tuguldur0/haven-badge/parts/boost/claude_kox4i6dn2g.png

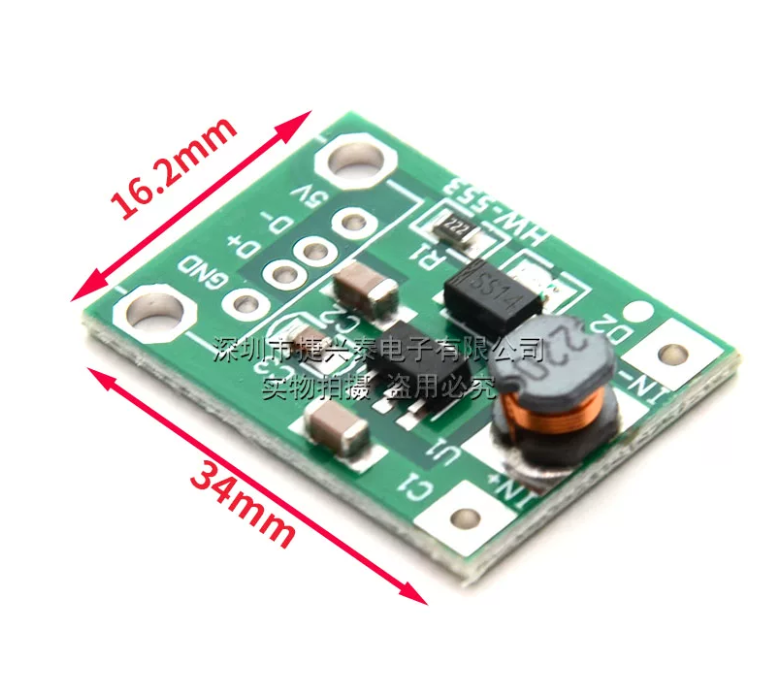
parts/boost/claude_kox4i6dn2g.png
