tuguldur0/haven-badge/parts/boost/claude_8iC5iIxjjv.png

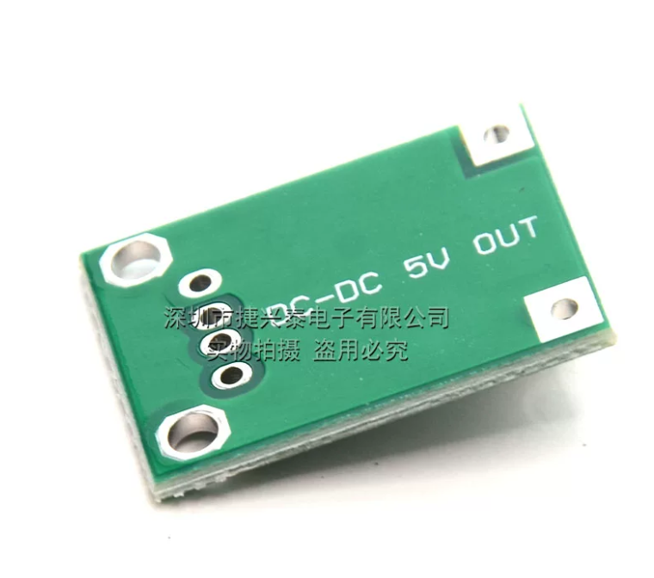
parts/boost/claude_8iC5iIxjjv.png
