tuguldur0/haven-badge/parts/boost/claude_3SXdJeQExv.png

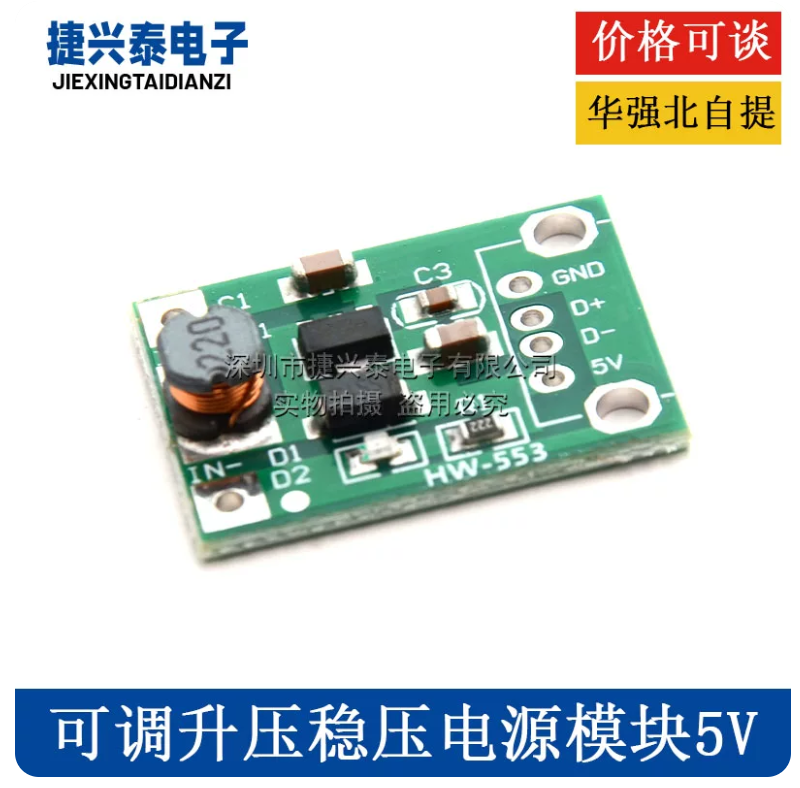
parts/boost/claude_3SXdJeQExv.png
