tuguldur0/haven-badge/parts/display/brave_M3mWcZekrh.png

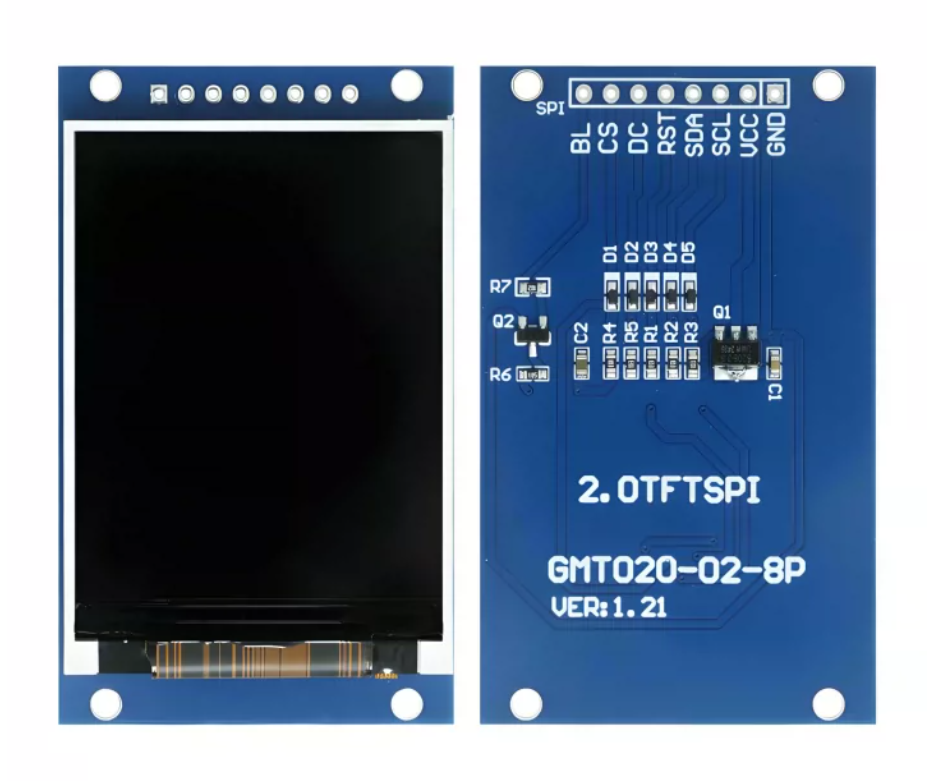
parts/display/brave_M3mWcZekrh.png
