tuguldur0/haven-badge/parts/display/brave_tNfNKGqZeg.png

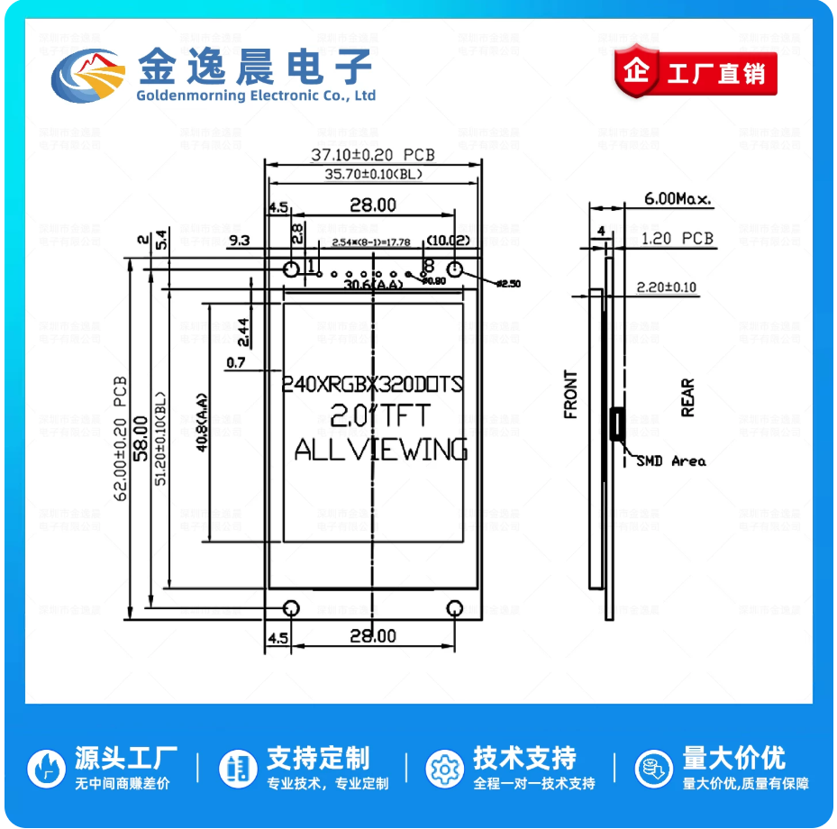
parts/display/brave_tNfNKGqZeg.png
