tuguldur0/haven-badge/parts/display/brave_YLbE1afcdx.png

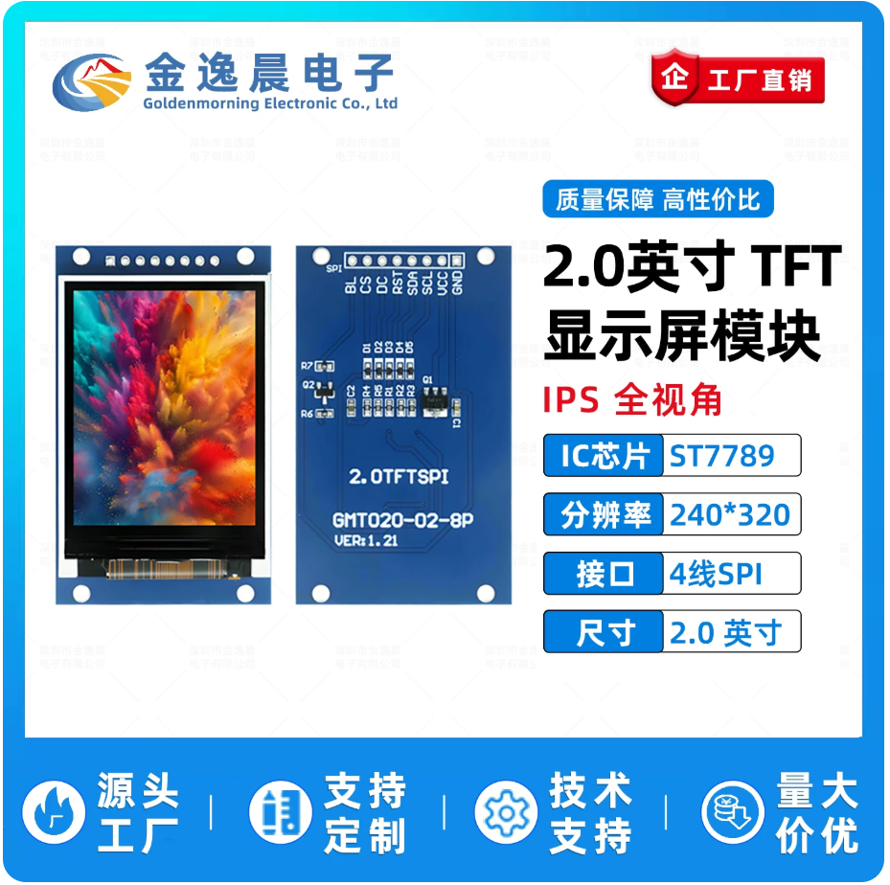
parts/display/brave_YLbE1afcdx.png
