tuguldur0/haven-badge/parts/module/brave_skoJ16uYzu.png

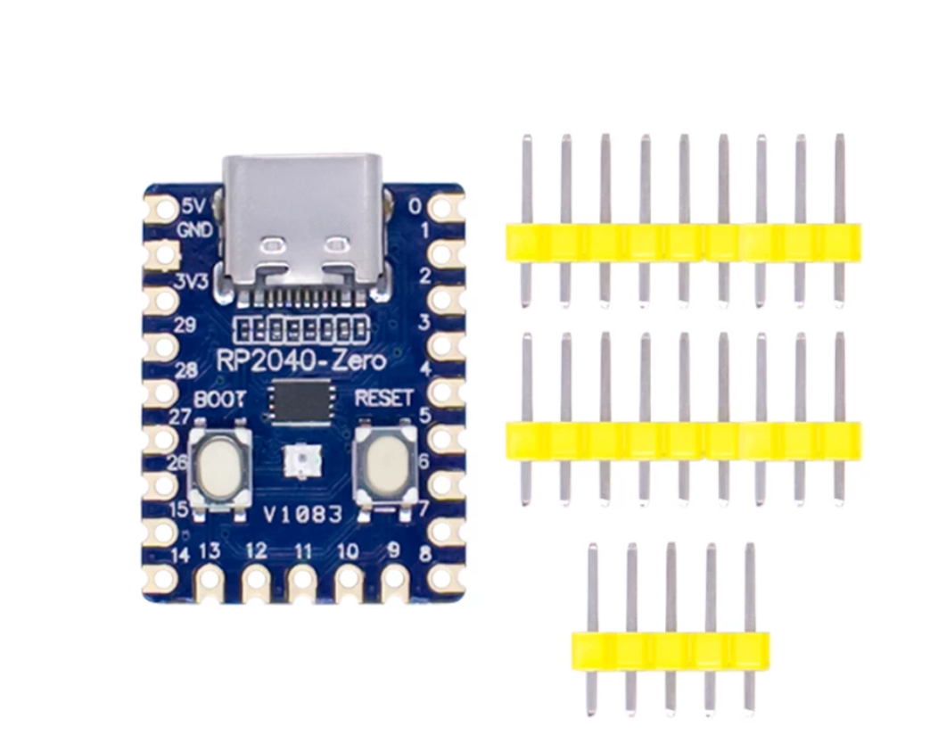
parts/module/brave_skoJ16uYzu.png
