tuguldur0/haven-badge/haven-badge.pdf

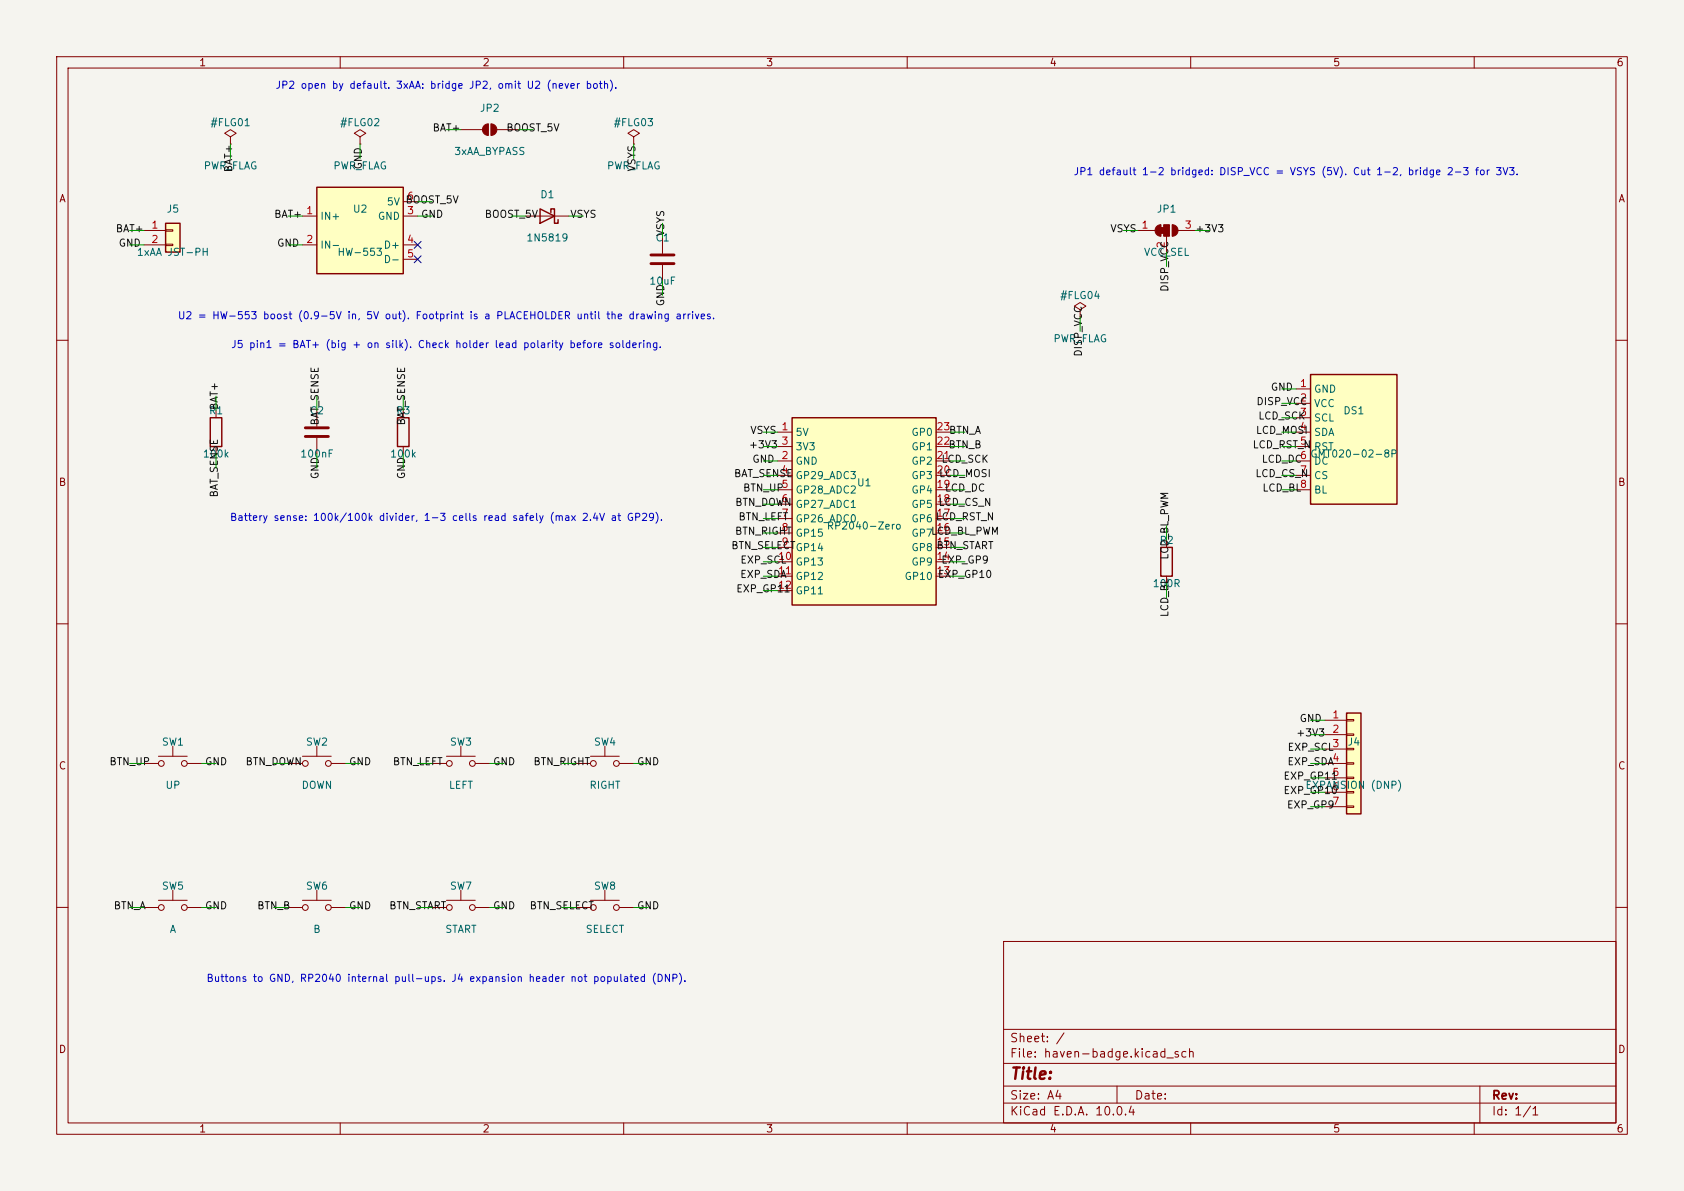
[picture p8: page 1]

Battery sense: 100k/100k divider, 1-3 cells read safely (max 2.4V at GP29). U2 = HW-553 boost (0.9-5V in, 5V out). Footprint is a PLACEHOLDER until the drawing arrives. JP2 open by default. 3xAA: bridge JP2, omit U2 (never both).

Size: A4 | Rev:
KiCad E.D.A. 10.0.4 | Id: 1/1
