tuguldur0/haven-badge/review/back/haven-badge.pdf

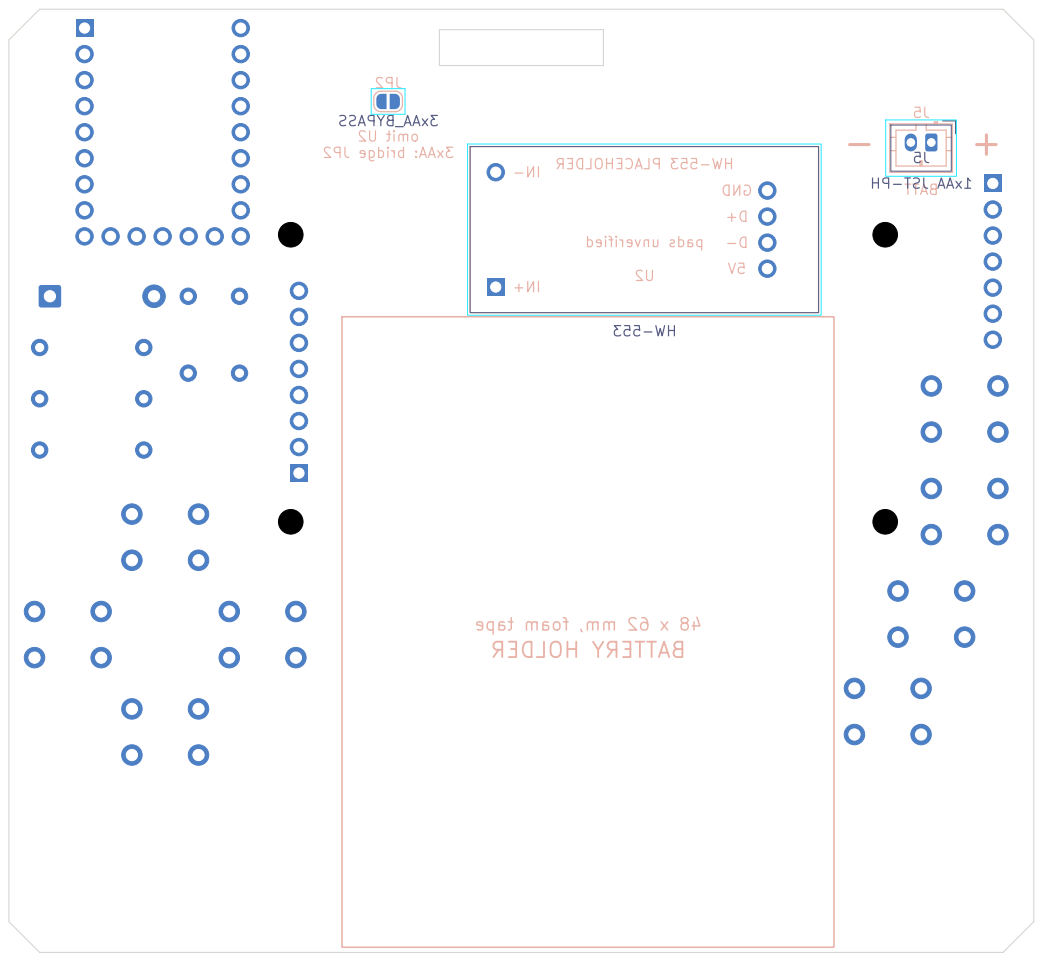
[picture p9: page 1]

JP2 bridge 3xAA: U2 omit HOLDER BATTERY

5V PLACEHOLDER HW-553 unverified pads
