tuguldur0/haven-badge/review/fit-test-1to1/haven-badge.pdf

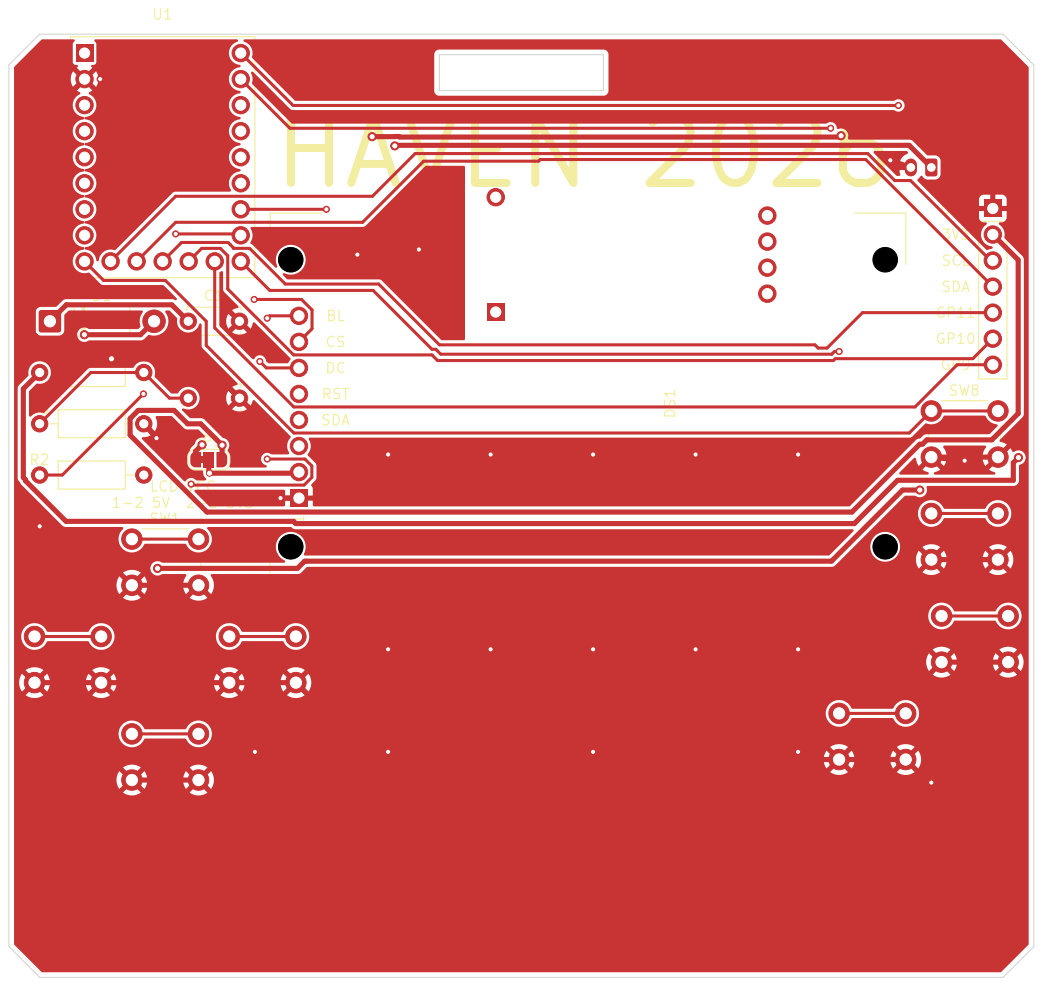
[picture p10: page 1]

CSBL
SCL SDA RST DC
