tuguldur0/haven-badge/review/front/haven-badge.pdf

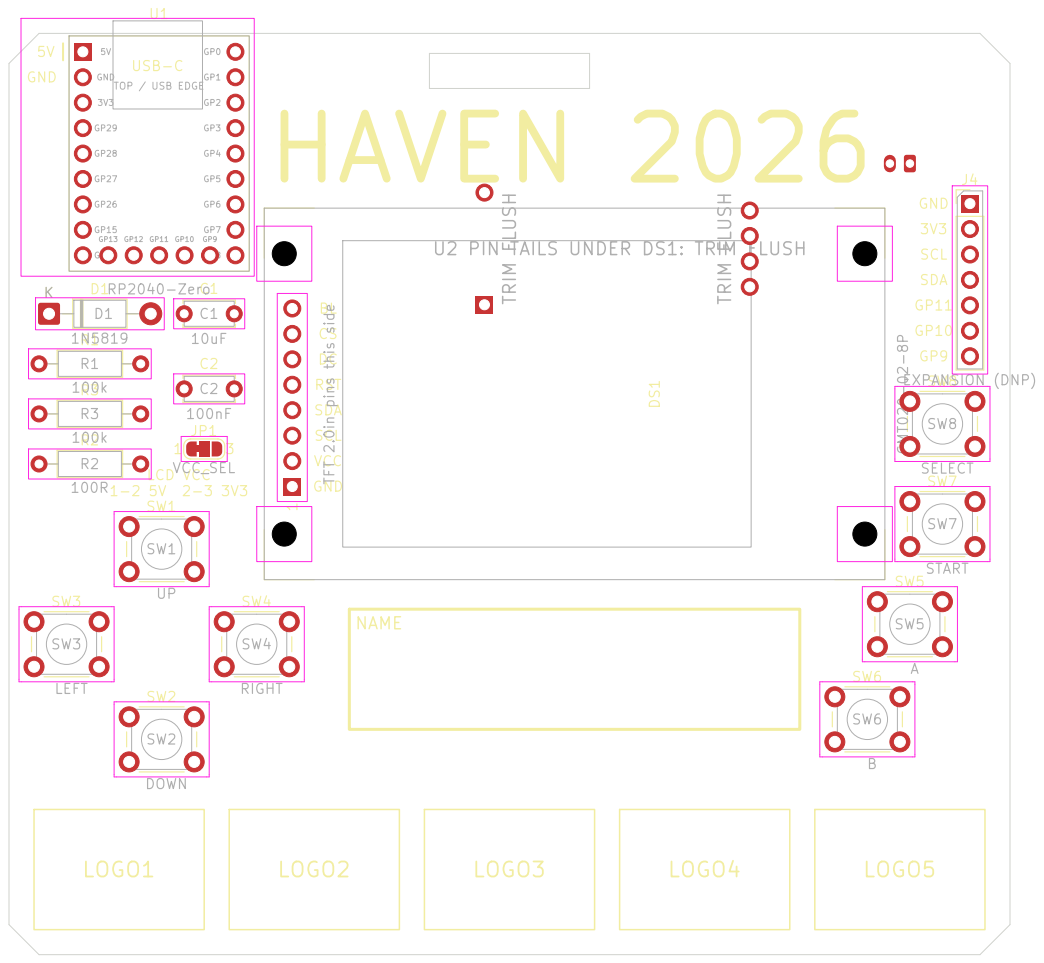
[picture p11: page 1]

SCL SDA RST DC
