tuguldur0/haven-badge/haven-badge.kicad_pcb

## KiCad design haven-badge.kicad_pcb (2026-10-20)

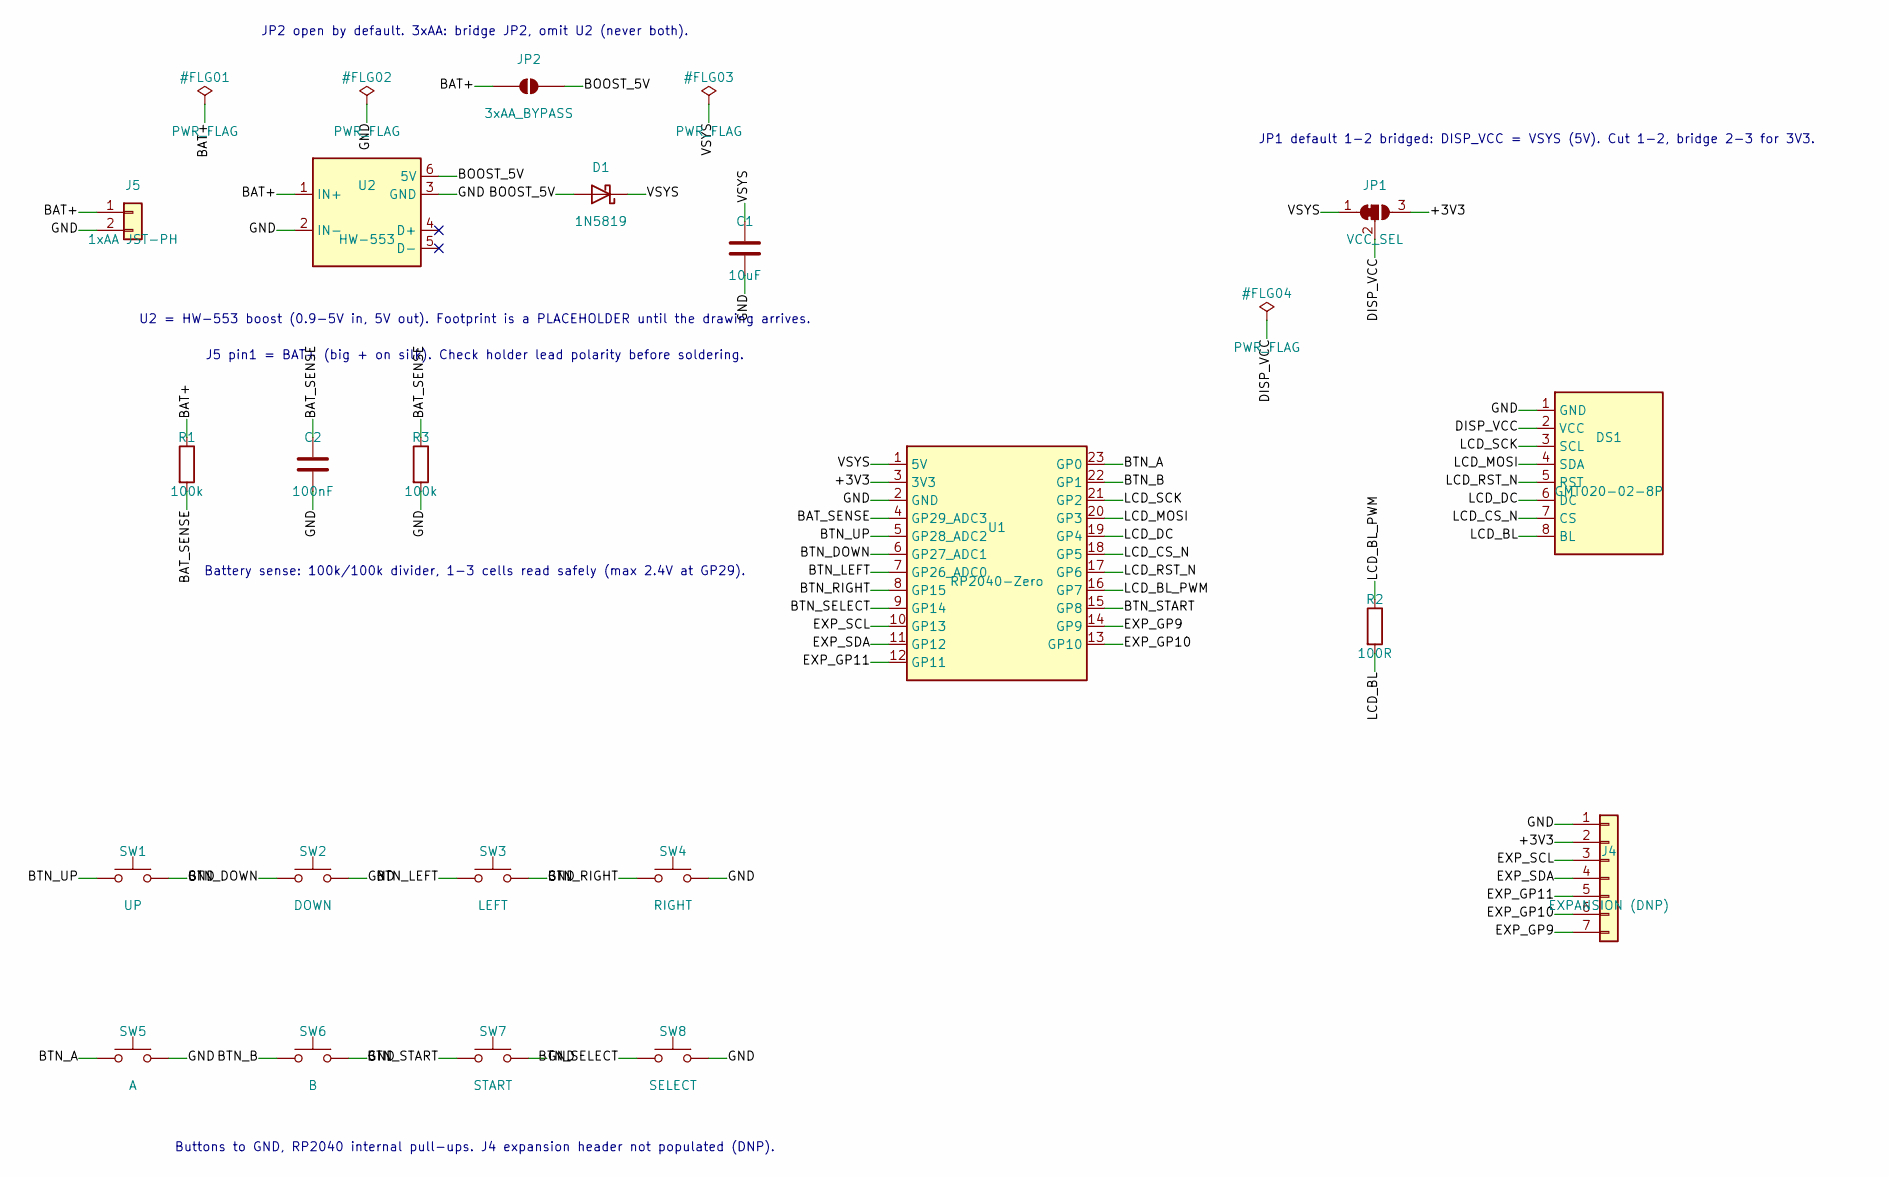
[picture p12: schematic haven-badge.kicad_sch]

Parts:
C1: 10uF; C_Disc_D5.0mm_W2.5mm_P5.00mm
C2: 100nF; C_Disc_D5.0mm_W2.5mm_P5.00mm
D1: 1N5819; D_DO-41_SOD81_P10.16mm_Horizontal
DS1: GMT020-02-8P; GMT020-02-8P_Socketed
J4: EXPANSION (DNP); PinHeader_1x07_P2.54mm_Vertical
J5: 1xAA JST-PH; JST_PH_B2B-PH-K_1x02_P2.00mm_Vertical
JP1: VCC_SEL; SolderJumper-3_P1.3mm_Bridged12_RoundedPad1.0x1.5mm_NumberL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
JP2: 3xAA_BYPASS; SolderJumper-2_P1.3mm_Open_RoundedPad1.0x1.5mm
R1, R3: 100k; R_Axial_DIN0207_L6.3mm_D2.5mm_P10.16mm_Horizontal
R2: 100R; R_Axial_DIN0207_L6.3mm_D2.5mm_P10.16mm_Horizontal
SW1: UP; SW_PUSH_6mm
SW2: DOWN; SW_PUSH_6mm
SW3: LEFT; SW_PUSH_6mm
SW4: RIGHT; SW_PUSH_6mm
SW5: A; SW_PUSH_6mm
SW6: B; SW_PUSH_6mm
SW7: START; SW_PUSH_6mm
SW8: SELECT; SW_PUSH_6mm
U1: RP2040-Zero; RP2040-Zero_Socketed
U2: HW-553; HW-553_Placeholder

Connections:
/+3V3: J4.2, JP1.3 (B), U1.3 (3V3)
/BAT+: J5.1, JP2.1 (A), R1.1, U2.1 (IN+)
/BAT_SENSE: C2.1, R1.2, R3.1, U1.4 (GP29_ADC3)
/BOOST_5V: D1.2 (A), JP2.2 (B), U2.6 (5V)
/BTN_A: SW5.1, U1.23 (GP0)
/BTN_B: SW6.1, U1.22 (GP1)
/BTN_DOWN: SW2.1, U1.6 (GP27_ADC1)
/BTN_LEFT: SW3.1, U1.7 (GP26_ADC0)
/BTN_RIGHT: SW4.1, U1.8 (GP15)
/BTN_SELECT: SW8.1, U1.9 (GP14)
/BTN_START: SW7.1, U1.15 (GP8)
/BTN_UP: SW1.1, U1.5 (GP28_ADC2)
/DISP_VCC: DS1.2 (VCC), JP1.2 (C)
/EXP_GP9: J4.7, U1.14 (GP9)
/EXP_GP10: J4.6, U1.13 (GP10)
/EXP_GP11: J4.5, U1.12 (GP11)
/EXP_SCL: J4.3, U1.10 (GP13)
/EXP_SDA: J4.4, U1.11 (GP12)
/GND: C1.2, C2.2, DS1.1 (GND), J4.1, J5.2, R3.2, SW1.2, SW2.2, SW3.2, SW4.2, SW5.2, SW6.2, SW7.2, SW8.2, U1.2 (GND), U2.2 (IN-), U2.3 (GND)
/LCD_BL: DS1.8 (BL), R2.2
/LCD_BL_PWM: R2.1, U1.16 (GP7)
/LCD_CS_N: DS1.7 (CS), U1.18 (GP5)
/LCD_DC: DS1.6 (DC), U1.19 (GP4)
/LCD_MOSI: DS1.4 (SDA), U1.20 (GP3)
/LCD_RST_N: DS1.5 (RST), U1.17 (GP6)
/LCD_SCK: DS1.3 (SCL), U1.21 (GP2)
/VSYS: C1.1, D1.1 (K), JP1.1 (A), U1.1 (5V)

Notes on the sheet:
U2 = HW-553 boost (0.9-5V in, 5V out). Footprint is a PLACEHOLDER until the drawing arrives.
J5 pin1 = BAT+ (big + on silk). Check holder lead polarity before soldering.
JP2 open by default. 3xAA: bridge JP2, omit U2 (never both).
Battery sense: 100k/100k divider, 1-3 cells read safely (max 2.4V at GP29).
Buttons to GND, RP2040 internal pull-ups. J4 expansion header not populated (DNP).
JP1 default 1-2 bridged: DISP_VCC = VSYS (5V). Cut 1-2, bridge 2-3 for 3V3.

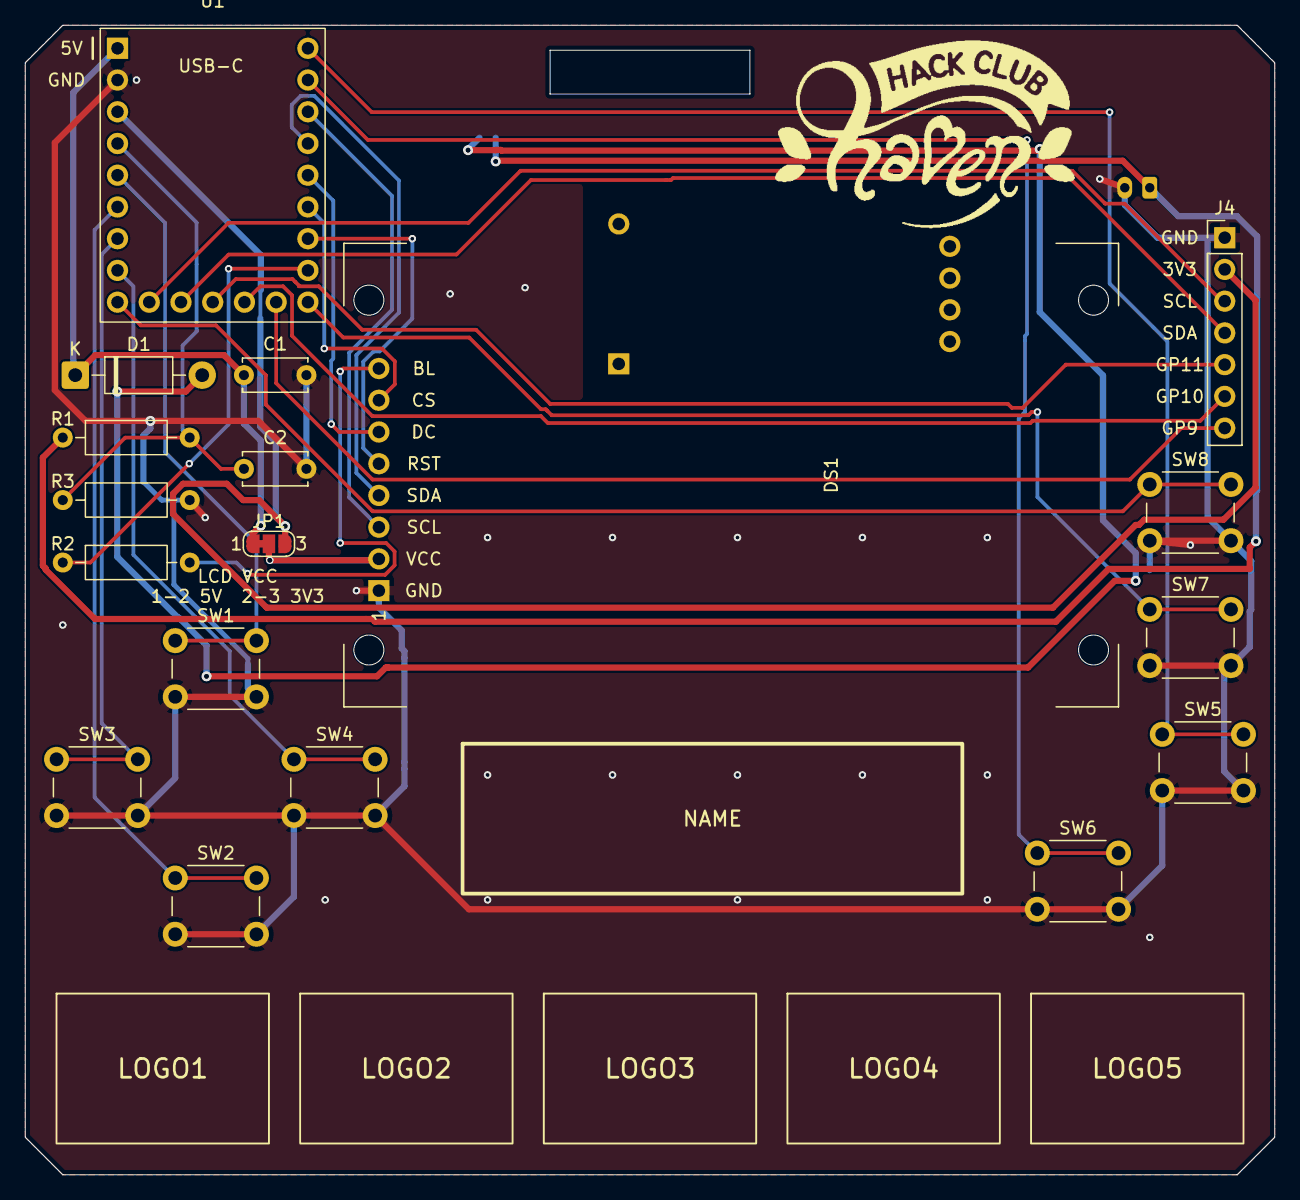
[picture p13: board haven-badge.kicad_pcb from above]

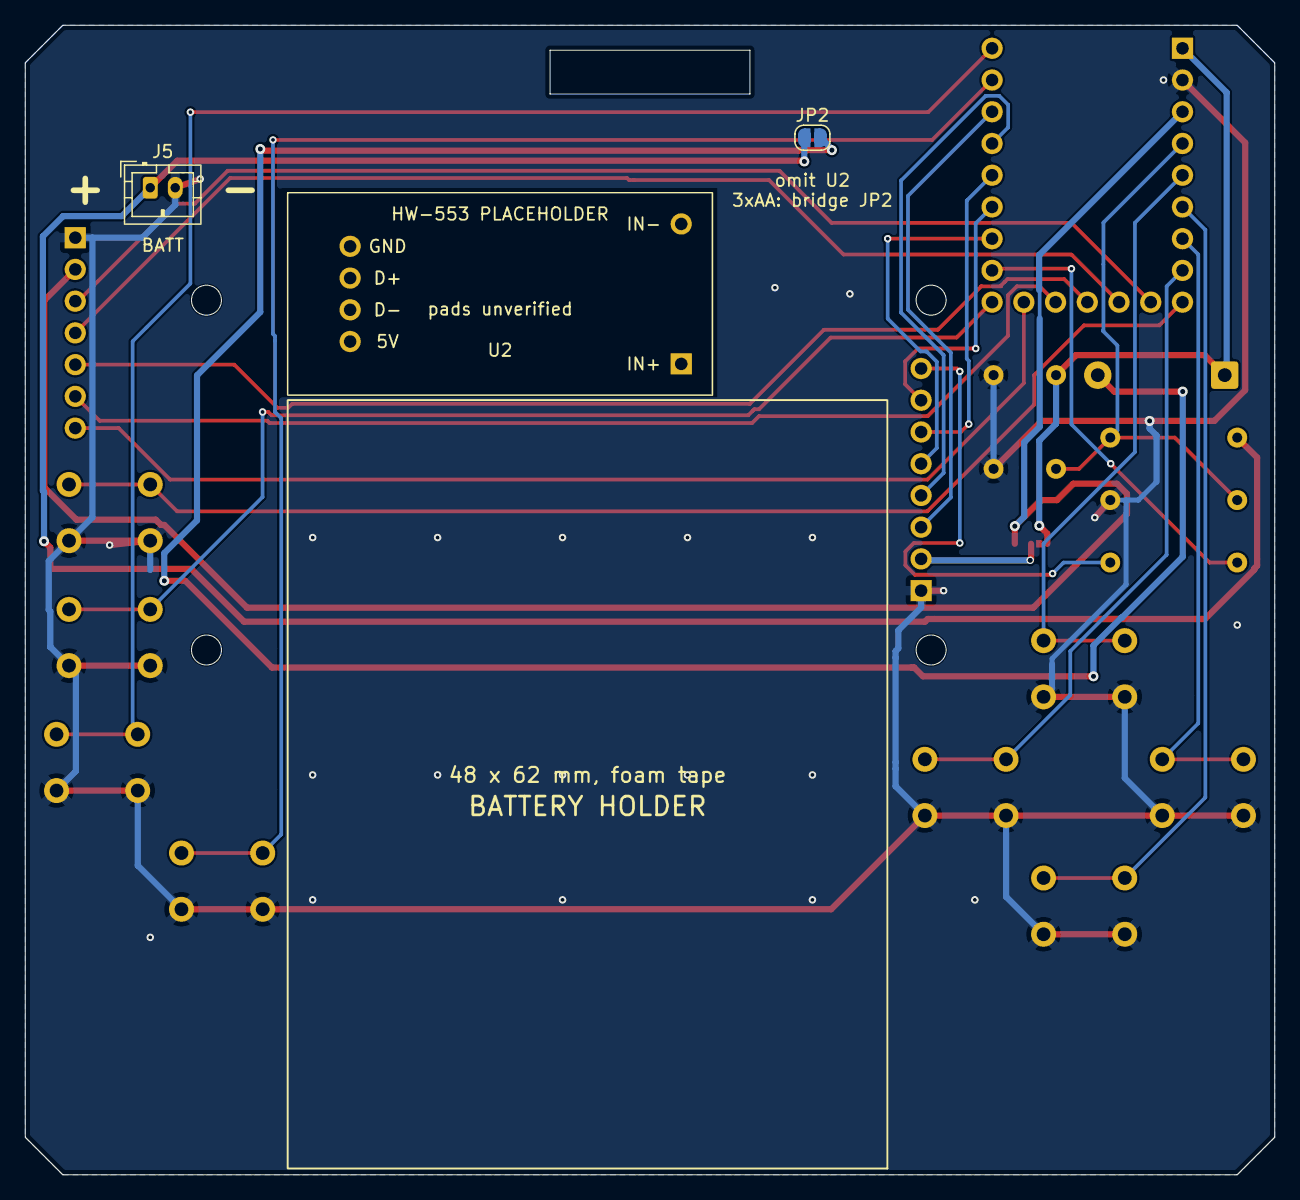
[picture p14: board haven-badge.kicad_pcb from below]

Board: 2 copper layers, 100.0 x 92.0 mm, 29 parts (6 on the bottom side), 27 nets.

Other parts of the board:
G1: Haven_Logo
G2: Name_Box
G3: Polarity_PH2
G4: J4_Labels
G5: JP2_Label
G6: JP1_Label
G7: Holder_Reserve
G8: Logo_Strip
